mawildoer/HeatherCrane/README.md

# HeatherCrane

The goal of this project is to provide independence through mobility to the sevearly disabled. 

Demo Video
