mawildoer/HeatherCrane/software/software.md

# Software

## `motor.h`

## `joystick.h`

### `JoyStickAxis`
For some ungodly reason the yaw pot in the joystick is logrithmic. [This forum post](https://electronics.stackexchange.com/questions/304692/formula-for-logarithmic-audio-taper-pot) is exceedingly helpful in linearizing the output
