mawildoer/HeatherCrane/electronics/power_stage.xlsx

Gate Driver Bootstrap Capacitor
MOSFET Gate Charge ( C) | Duty Cycle | Switching Frequency (Hz) | Cycle Time (s) | VDD I Bias (A) | Total Charge Requirement ( C) | Allowable Ripple | Driver Voltage (V) | Ripple (V) | Minimum Capacitance ( C)
3e-08 | 90% | 20000 | 5e-05 | 0.003 | 1.65e-07 | 5% | 10 | 0.5 | 3.3e-07
Gate Driver Bootstrap Max Resistor
Selected Capacitance ( C) | Max Resistance | Use Resistor
2.7e-07 | 3.03030303 | Yes
Gate Driver Boostrap Current
Minimum Charge Time (S) | Max Charge Current (A) | Max Charge Current (mA) | Average Charge Current (A) | Average Charge Current (mA)
5e-06 | 0.054 | 54.00 | 0.0036 | 3.60
