mawildoer/HeatherCrane/hardware/joystick_mount_1.stl

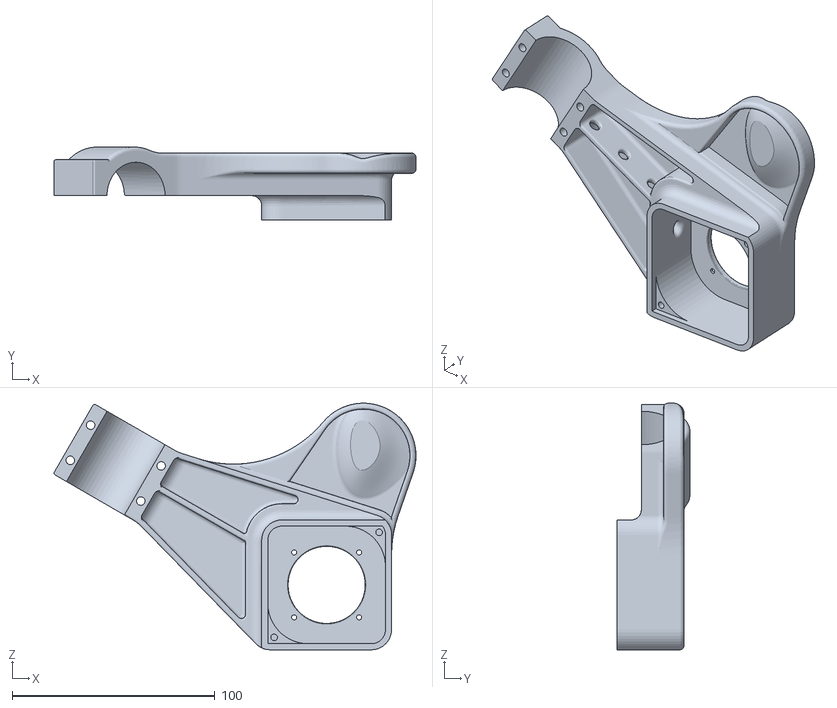
[picture p1: CAD file, 2019-04-19]
hardware/joystick_mount_1.stl
178.4 x 36.0 x 121.5
