mawildoer/HeatherCrane/hardware/joystick_mount_3.stl

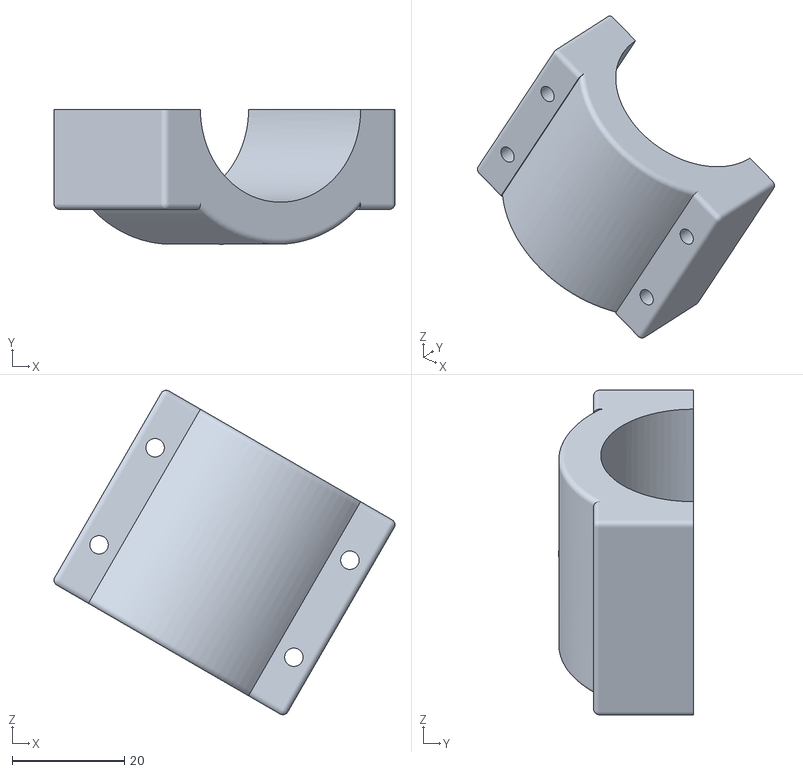
[picture p2: CAD file, 2019-04-19]
hardware/joystick_mount_3.stl
60.8 x 24.0 x 57.9
