mawildoer/HeatherCrane/hardware/joystick_mount_2.stl

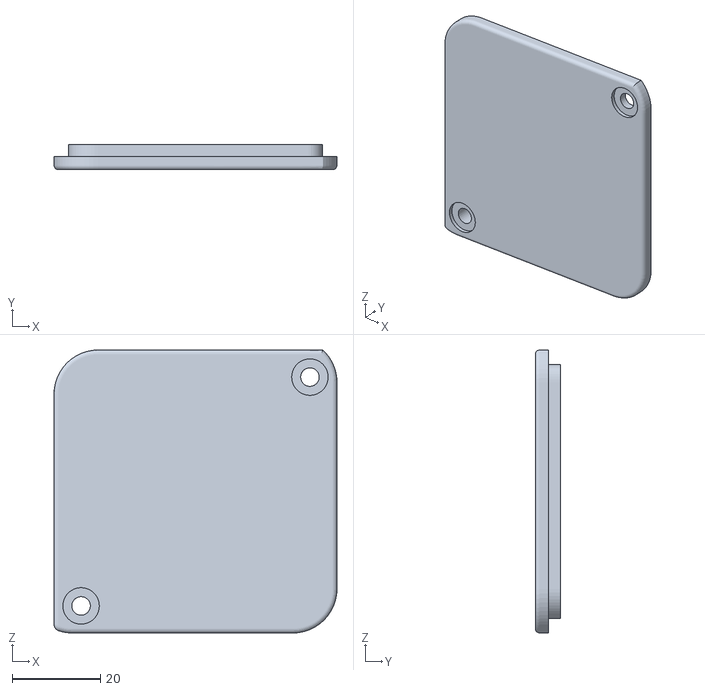
[picture p3: CAD file, 2019-04-19]
hardware/joystick_mount_2.stl
64.0 x 5.75 x 64.0
