mawildoer/HeatherCrane/(list of files, cad)

Other CAD files:
hardware/joystick_mount v4.f3d
