mawildoer/HeatherCrane/electronics/driver_board/driver.brd

## EAGLE design electronics/driver_board/driver.brd (2019-05-11)

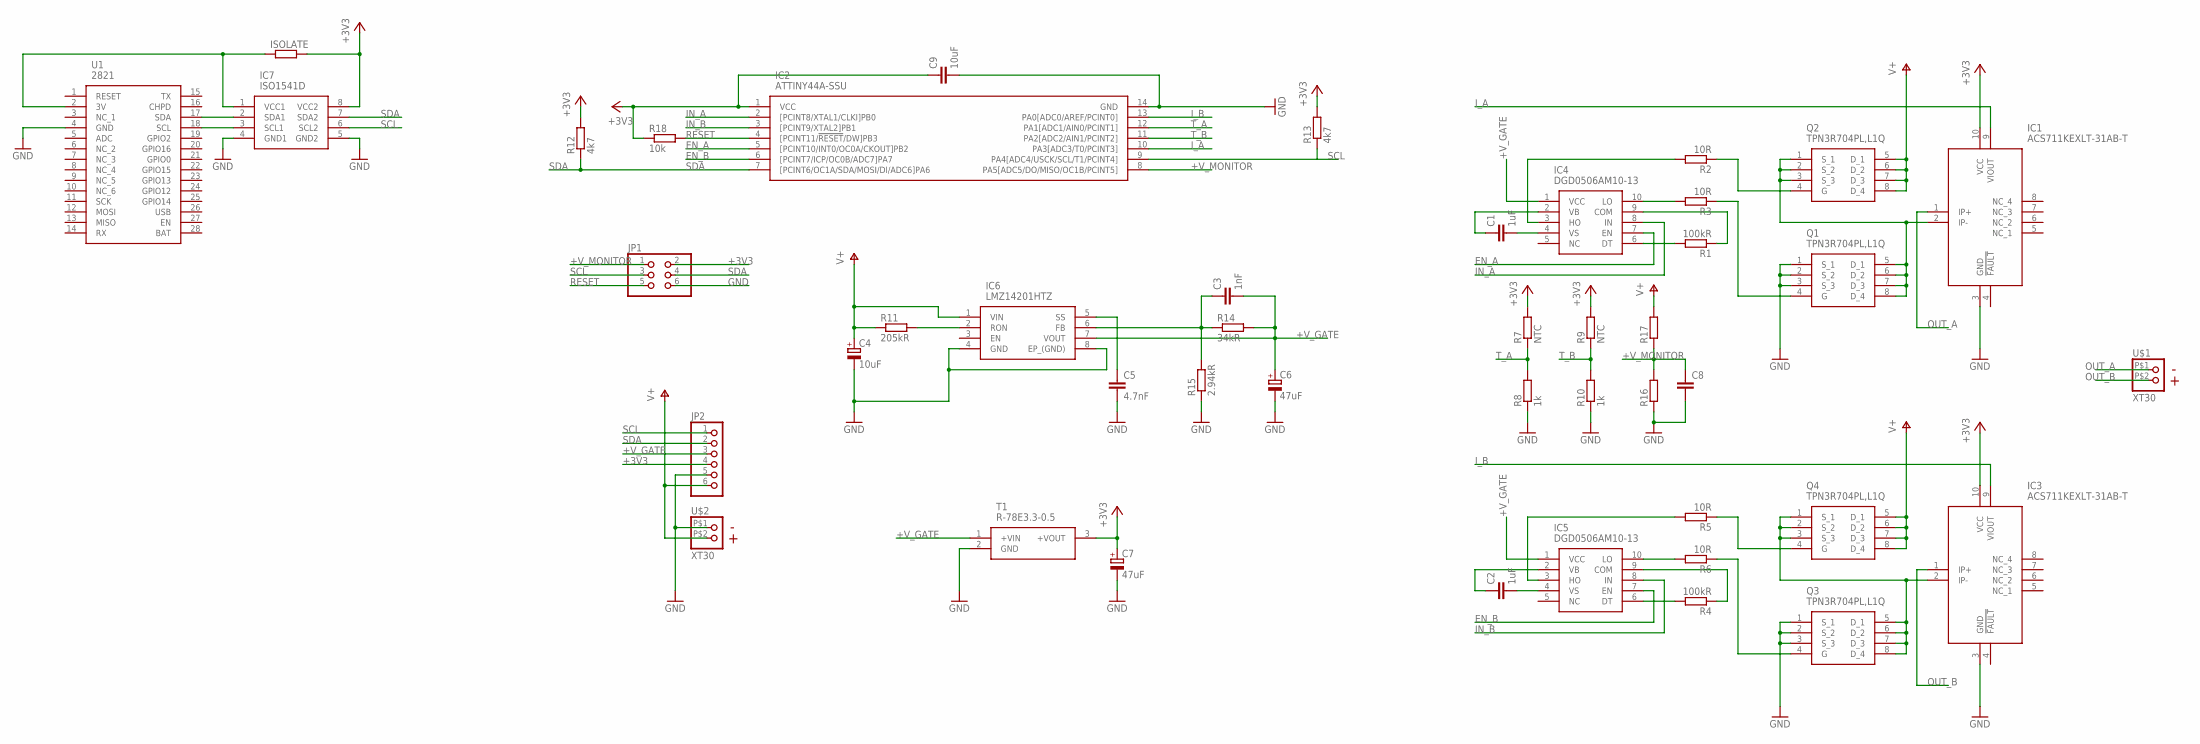
[picture p4: schematic driver.sch]

Parts:
C1, C2: 1uF; C0603
C3: 1nF; C0603
C4: 10uF; E2,5-6E
C5: 4.7nF; C0603
C6, C7: 47uF; E2,5-6E
C8: C-EUC0603; C0603
C9: 10uF; C0603
IC1, IC3: ACS711KEXLT-31AB-T; EX-PACKAGE
IC2: ATTINY44A-SSU; SOIC127P600X175-14N
IC4, IC5: DGD0506AM10-13; SOP50P490X110-10N
IC6: LMZ14201HTZ; NDW0007A
IC7: ISO1541D; SOIC127P600X175-8N
ISOLATE: R-EU_R0805; R0805
JP1: PINHD-2X3; 2X03
JP2: PINHD-1X6; 1X06
Q1, Q2, Q3, Q4: TPN3R704PL,L1Q; TSON_ADVANCE
R1, R4: 100kR; R0603
R2, R3, R5, R6: 10R; R0603
R7, R9: NTC; R0603
R8, R10: 1k; R0603
R11: 205kR; R0603
R12, R13: 4k7; R0603
R14: 34kR; R0603
R15: 2.94kR; R0603
R16, R17: R-EU_R0603; R0603
R18: 10k; R0603
T1: R-78E3.3-0.5; SHDRV3W100P0_254_1X3_1160X850X
U1: 2821
U$1, U$2: XT30

Connections:
+3V3: C7.+, C9.1, IC1.10 (VCC), IC2.1 (VCC), IC3.10 (VCC), IC7.8 (VCC2), ISOLATE.2, JP1.2, JP2.4, R7.2, R9.2, R12.2, R13.2, R18.1, T1.3 (+VOUT)
+V_GATE: C3.2, C6.+, IC4.1 (VCC), IC5.1 (VCC), IC6.7 (VOUT), JP2.3, R14.2, T1.1 (+VIN)
+V_MONITOR: C8.1, IC2.8 (PA5[ADC5/DO/MISO/OC1B/PCINT5]), JP1.1, R16.2, R17.1
EN_A: IC2.5 ([PCINT10/INT0/OC0A/CKOUT]PB2), IC4.7 (EN)
EN_B: IC2.6 ([PCINT7/ICP/OC0B/ADC7]PA7), IC5.7 (EN)
GND: C4.-, C5.2, C6.-, C7.-, C8.2, C9.2, IC1.3 (GND), IC2.14 (GND), IC3.3 (GND), IC6.4 (GND), IC6.8 (EP_(GND)), IC7.4 (GND1), IC7.5 (GND2), JP1.6, JP2.5, Q1.1 (S_1), Q1.2 (S_2), Q1.3 (S_3), Q3.1 (S_1), Q3.2 (S_2), Q3.3 (S_3), R8.1, R10.1, R15.1, R16.1, T1.2 (GND), U1.4 (GND), U$2.P$1 (1)
IN_A: IC2.2 ([PCINT8/XTAL1/CLKI]PB0), IC4.8 (IN)
IN_B: IC2.3 ([PCINT9/XTAL2]PB1), IC5.8 (IN)
I_A: IC1.9 (VIOUT), IC2.10 (PA3[ADC3/T0/PCINT3])
I_B: IC2.13 (PA0[ADC0/AREF/PCINT0]), IC3.9 (VIOUT)
unnamed: IC3.2 (IP-), Q3.5 (D_1), Q3.6 (D_2), Q3.7 (D_3), Q3.8 (D_4), Q4.1 (S_1), Q4.2 (S_2), Q4.3 (S_3)
unnamed: Q2.4 (G), R2.1
unnamed: C1.2, IC4.4 (VS)
unnamed: C1.1, IC4.2 (VB)
unnamed: Q4.4 (G), R5.1
unnamed: IC1.2 (IP-), Q1.5 (D_1), Q1.6 (D_2), Q1.7 (D_3), Q1.8 (D_4), Q2.1 (S_1), Q2.2 (S_2), Q2.3 (S_3)
unnamed: Q1.4 (G), R3.1
unnamed: IC4.6 (DT), R1.2
unnamed: IC4.9 (COM), R1.1
unnamed: IC4.3 (HO), R2.2
unnamed: IC4.10 (LO), R3.2
unnamed: C2.2, IC5.4 (VS)
unnamed: C2.1, IC5.2 (VB)
unnamed: Q3.4 (G), R6.1
unnamed: IC5.6 (DT), R4.2
unnamed: IC5.9 (COM), R4.1
unnamed: IC5.3 (HO), R5.2
unnamed: IC5.10 (LO), R6.2
unnamed: IC7.2 (SDA1), U1.17 (SDA)
unnamed: IC6.2 (RON), R11.2
unnamed: C3.1, IC6.6 (FB), R14.1, R15.2
unnamed: C5.1, IC6.5 (SS)
unnamed: IC7.3 (SCL1), U1.18 (SCL)
unnamed: IC7.1 (VCC1), ISOLATE.1, U1.2 (3V)
OUT_A: IC1.1 (IP+), U$1.P$1 (1)
OUT_B: IC3.1 (IP+), U$1.P$2 (2)
RESET: IC2.4 ([PCINT11/!RESET!/DW]PB3), JP1.5, R18.2
SCL: IC2.9 (PA4[ADC4/USCK/SCL/T1/PCINT4]), IC7.6 (SCL2), JP1.3, JP2.1, R13.1
SDA: IC2.7 ([PCINT6/OC1A/SDA/MOSI/DI/ADC6]PA6), IC7.7 (SDA2), JP1.4, JP2.2, R12.1
T_A: IC2.12 (PA1[ADC1/AIN0/PCINT1]), R7.1, R8.2
T_B: IC2.11 (PA2[ADC2/AIN1/PCINT2]), R9.1, R10.2
V+: C4.+, IC6.1 (VIN), JP2.6, Q2.5 (D_1), Q2.6 (D_2), Q2.7 (D_3), Q2.8 (D_4), Q4.5 (D_1), Q4.6 (D_2), Q4.7 (D_3), Q4.8 (D_4), R11.1, R17.2, U$2.P$2 (2)

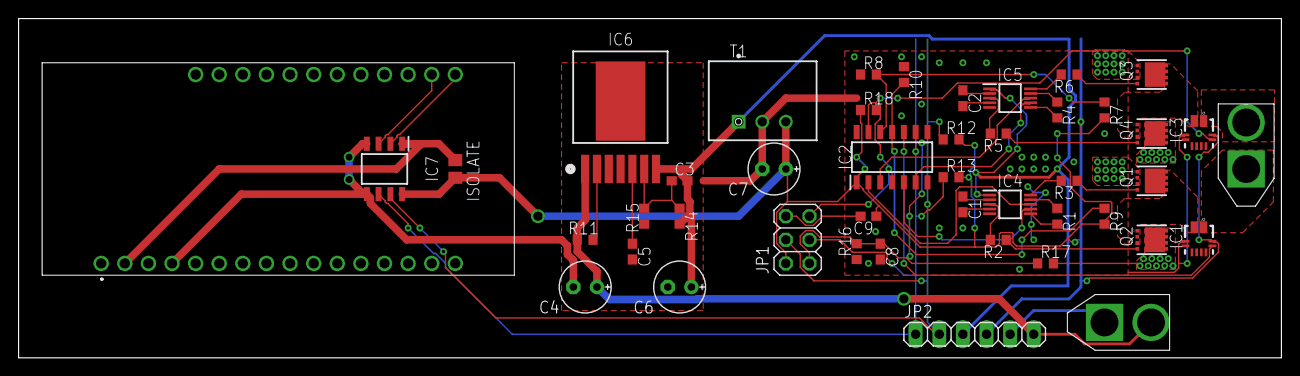
[picture p5: board driver.brd from above]

Board: 2 copper layers, 135.9 x 36.5 mm, 45 parts (0 on the bottom side), 42 nets.
