mawildoer/HeatherCrane/(commit log)

2019-02-21 Motor Controller v1
    6 full bridge, 30A continuous integrated drivers which allow for control of the four wheels and the linear actuators from a Teensy LC. The inputs are low pass filtered and to reduce noise on the lines from the joystick
    [motor_controller.brd, motor_controller.sch]
2019-02-22 Design Review V1
    Changed the signal levels from V+ to 3V3 with 3K3 resistors
    [bom.csv, motor_controller.brd, motor_controller.sch]
2019-03-01 Added digikey to BOM
    [DC_motor_shield.csv, bom.csv, motor_controller.brd, motor_controller.sch]
2019-03-31 hbridge motor setup functions (as long as you select the right pins in software... ooops)
2019-04-09 Added joystick mount
    [joystick_mount v4.f3d, joystick_mount_1.stl, joystick_mount_2.stl, joystick_mount_3.stl]
2019-04-19 Update mounting holes in joystick mount
    [joystick_mount_1.stl, joystick_mount_2.stl, joystick_mount_3.stl]
2019-05-10 Driver Review
    [DC_motor_shield.csv, driver.brd, driver.sch, motor_controller.brd, motor_controller.sch, power_stage.xlsx]
2019-05-11 For review 2
    [driver.brd, driver.sch]
